xenpac/Linux-DVB-S2-SatReceiver/docu/bsbe2-401a-nim-tuner/DVBworld-HD2104-Bottom.jpg

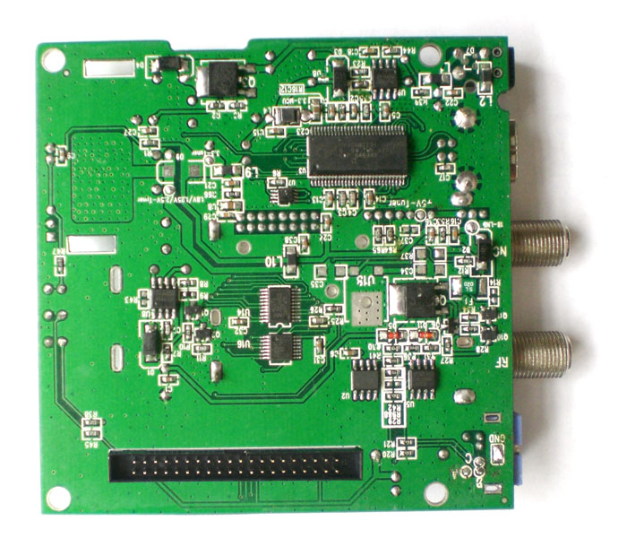
docu/bsbe2-401a-nim-tuner/DVBworld-HD2104-Bottom.jpg
