xenpac/Linux-DVB-S2-SatReceiver/docu/bsbe2-401a-nim-tuner/DVBworldHD2104-Top.jpg

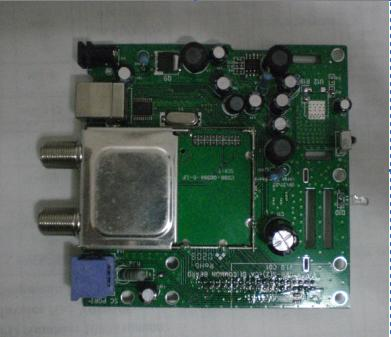
docu/bsbe2-401a-nim-tuner/DVBworldHD2104-Top.jpg
