xenpac/Linux-DVB-S2-SatReceiver/docu/bsbe2-401a-nim-tuner/tunerback.jpg

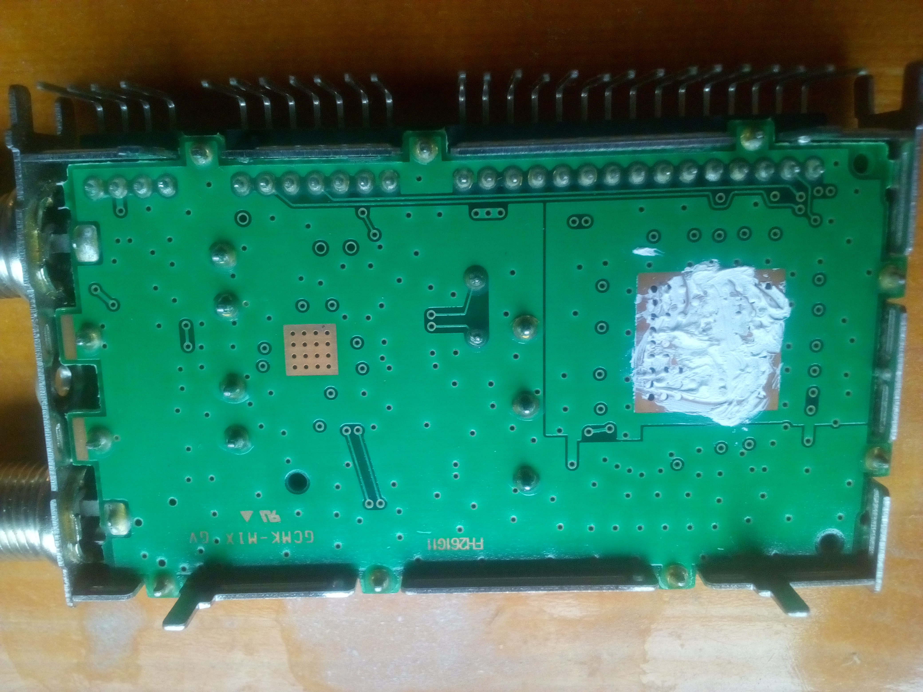
docu/bsbe2-401a-nim-tuner/tunerback.jpg
