xenpac/Linux-DVB-S2-SatReceiver/(list of files, cad)

Other CAD files:
firmware/sourcecode-dvb-usb-dw2104/mpeg-tv/mpegts.OBJ
