xenpac/Linux-DVB-S2-SatReceiver/(threads)

Thread 1 (2022-11-21):

Gx6605s hd satellite receiver chip, Linux kernel support

siliconhippy, 2022-11-21:
Hi xenpac,

Great project. I actually am not a dev or hardware guy, but was wondering about this dvb chipset that seems fully supported in the Linux kernel and heavily used in many $25+ DVB-S2 receivers from Ali Express etc:

https://www.google.com/amp/s/www.cnx-software.com/2018/11/12/c-sky-linux-development-board-gx6605s-media-soc/%3famp=1

Can you have a look and let me know if it is directly possible to connect a gx6605s DVB-S2 receiver to Linux PC and stream satellite mux tv channels to VLC/ tvheadend for network distribution?

The gx6605s board seems well supported but it will be really cool to stream channels to a Linux PC! This should be then an easier project that having to assemble hardware; just buy a cheap satellite receiver. 😃

xenpac, 2023-05-13:
Oh, hi, sorry for late reply.

I have also looked at those GX6605 receivers.
Well, those are "closed" boxes acting as a sat receiver outputting video/audio to a TV/Terminal.
There is no Linux DVB interface at all.
Some have a network interface /wifi/ethernet via USB.

There might be a Network streaming output, but who knows how it works to control it.
Not that i know of.

Some try to hack those boxes and run linux on it.
But, you cant get hardware access to the tuner etc.
There is no hardware documentation as to my knowledge.

So unfortunately, i guess no.

Thread 3 (2023-06-23):

BSBE2-401A vs RDA5815

indotronic, 2023-06-23:
BSBE2-401A is old component and no much in market today.
I see some module STB now using RDA5815 and chip gx6605s.  Can RDA5815 connect to SBC like raspberry pi?

xenpac, 2023-07-28:
Linux DVB framework is quite old, so doesnt support newer chipsets.

Thread 4 (2023-07-05):

fx2lp.hex how work?

Ackleys, 2023-07-05:
Hello, friend. Is fx2lp.hex implemented like this? It uses VID 04B4, Product ID: 2104, and then simply passes the data stream from the FIFO to the USB, right?

Ackleys, 2023-07-05:
I'm not good at English,I have examined the schematic and discovered that it also includes a USB to I2C functionality. Could you kindly provide the source code for fx2lp.hex? Thank you

xenpac, 2023-07-28:
yes I2C is used to send commands, get status from the receiver.
the mpreg stream is send from the receiver over the fx2lp to the linux kernel.
i might add the source for reference.

Thread 7 (2024-09-27):

Working with original dvb-usb-dw2104.fw?

jonnyh64, 2024-09-27:
Does your hardware work with the original dvb-usb-dw2104.fw? From what I can see, the original one uses PA6 for h/v control (instead of PD0 in your schematic). But apart from this, it should work?

jonnyh64, 2024-09-29:
I found another difference: The original firmware sets IFCONFIG = 0xcb, where your firmware sets IFCONFIG = 0x03. This means, the original firmware uses asynchronous slave FIFO mode, where your firmware uses synchronous slave mode.

For the wiring, this means:
- The original firmware needs demod CLKOUT connected to SLWR. I'm also pretty sure that demod SYNC is connected to PA6/PKTEND.
- Your firmware needs demod CLKOUT connected to IFCLK. I'm surprised that SYNC is not connected?!

In your schematic, demod Data_Valid is connected to SLWR, so that IFCLK is ignored while SLWR is inactive. I'm not quite sure how the original firmware handles this. Maybe the demod does not use Data_Valid at all - it can just stop CLKOUT when no data is being transmitted, but this might be configurable. But maybe it needs demod Data_Valid connected to SLCS, which would then require a certain output polarity on demod side, because it is not configurable on the FX2 side.

xenpac, 2024-09-29:
Oh hi jonny,
we have an expert here ;)

I am a bit away from the details.
Yes SYNC is not connected for some reason. i have to look into the demod datasheet.
so i only fetch the data from demod when data_valid is on.
It toggle between the packets.

In asynchronous mode (IFCONFIG.3 = 1), SLRD and SLWR
are   read   and   write   strobes;   in   synchronous   mode
(IFCONFIG.3 =  0),  SLRD  and  SLWR  are  enables  for  the
IFCLK clock pin.

So i use data_valid to let the clock input the data if active.

PORTA alternate Pin configurations is activated when  IFCONFIG = 0x03; enabling slave fifo mode.
ifconfig 0xcb is bin 1100 1011, so async mode, IFCLKSRC,  3048MHZ , 0,0, ASYNC ,0, IFCFG1 ,IFCFG0
maybe 3048MHZ should be 1 for 48mhz fifo clock.

i dont have the original hardware so i dont know if my firmware works on it. i guess not.
But you can adjust the software and check.

you seem to have the original sourcecode. ?

jonnyh64, 2024-09-29:
I don't have the original source code, just a disassembly, and the 8051 code is relatively easy to read. Actually I'm designing my own DVB device PCB (also with the FX2 chip), so I'm using any opportunity to study the details, hoping to limit the number of bodge wires necessary. Also I hope that I can reuse some existing FX2 firmware - because getting all the details right seems like a nightmare, and sharing a self-written firmware binary based on the Cypress libraries seems legally questionable.

I've digged a little more and can see that the original dvb-usb-dw2104.fw sets PORTACFG = 0, i.e. the SLCS pin function is disabled (even though the CX24116 would allow to adjust the Data_Valid polarity via MPEGConfig/MPGValidPol register to match what the FX2 expects).

So, my interpretation is that on the original hardware, Data_Valid is not used and that the demod only generates CLKOUT edges when there is valid data transmitted. The CX24116 allows that by setting the MPEGConfig/MPGClkGap register to 1. The weird thing is that the linux driver (drivers/media/dvb-frontends/cx24116.c, search for CMD_MPEGCONFIG) does *NOT* set this bit.

As you are confirming that you observed data_valid actually toggling,  I have no clue how Linux driver can work with the original firmware and hardware...

jonnyh64, 2024-09-29:
Maybe I have found the explanation how it works. The Linux driver sets the MPEGConfig/MPEGSyncPunc bit to 1, which enables "Sync word is punctured" behavior. I admit that I never heard the term "puncture" in context of a digital signal, but I'm guessing that this means that the demod SYNC signal is pulled low when the 188-byte TS packet ends (and the high-low edge triggers sending the packet via USB) and then also *KEPT* low when the error detection/correction bytes are sent. While I find no clear evidence in the FX2 TRM, I'm assuming that keeping PKTEND low also leads to SLWR edges being ignored.

I will base my PCB on that assumption, but also keep all other pins routed to pin headers, just in case.

Not sure if you are still working on the project, but maybe this helps you to also switch to the original firmware and frees you from the burden of maintaining your own.

jonnyh64, 2024-09-29:
Thinking some more, I guess demod data_valid is simply connected to FX2 PKTEND. This could make it compatible also to other demods.

xenpac, 2024-09-29:
Ok, so you are disassembling the original firmware file to evaluate how it works.
and you are designing your own PCB for a ? sat receiver, based on the same Tuner/NIM ? or something else?
yes the FX2 cypress device is quite versatile and can interface various hardware via USB to PC.
I like FX2,

jonnyh64, 2024-09-29:
My primary goal of the disassembly is to make a hardware which is compatible with the existing firmware.

It will be based on a different NIM (with Montage tuner & demod). I will probably publish it under an open hardware license, so everybody can adapt it to other NIMs. As DVB usage seems to be declining more and more it might be an opportunity to recycle old hardware. Together with a Raspberry Pi it makes a nice STB - this would have been a popular device in the 2000s and early 2010s, but nowadays I guess not many people will be interested. So now it mainly serves for my self-education with PCB design and switching power supplies and linear regulators...

0wwafa, 2025-02-07:
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

where can I find the original dvb-usb-dw2104.fw ?

xenpac, 2025-02-07:
Demod Data is fetched syncroniously while data-valid asto clkout.

Ori Fw is in Linux folder /firmware
