xenpac/Linux-DVB-S2-SatReceiver/docu/dvb-tuner-schematic.pdf

| | | | LCsoft Board with USB Conn

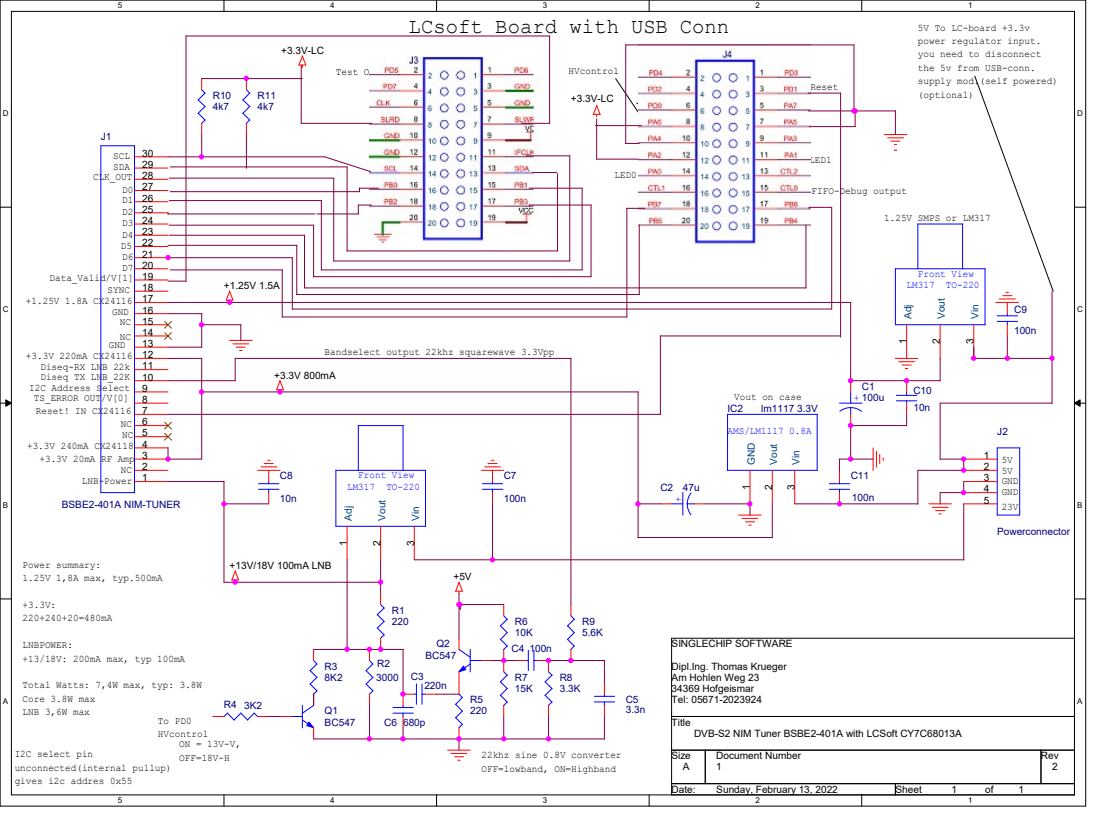
[picture p7: page 1]

5V To LC-board +3.3v
power regulator input.
you need to disconnect
the 5v from USB-conn.
supply mod.(self powered)
(optional)

Dipl.Ing. Thomas Krueger
Am Hohlen Weg 23
34369 Hofgeismar
Tel: 05671-2023924

Total Watts: 7,4W max, typ: 3.8W
Core 3.8W max
LNB 3,6W max

DVB-S2 NIM Tuner BSBE2-401A with LCSoft CY7C68013A

22khz sine 0.8V converter
OFF=lowband, ON=Highband

Date: Sunday, February 13, 2022 | Sheet 1 of 1
