xenpac/Linux-DVB-S2-SatReceiver/(notices)

Notices in the files:
docu/bsbe2-401a-nim-tuner/cx24116-elixir.c:
This program is free software; you can redistribute it and/or modify
it under the terms of the GNU General Public License as published by
the Free Software Foundation; either version 2 of the License, or
(at your option) any later version.
